BroncoSpace-Lab/CADENCE-Power/README.md

This repository contains the development of the Solar and Battery Management system Boards that will be used for the CADENCE mission.
