BroncoSpace-Lab/CADENCE-Power/CADENCE Inhibit System Test Board/.step

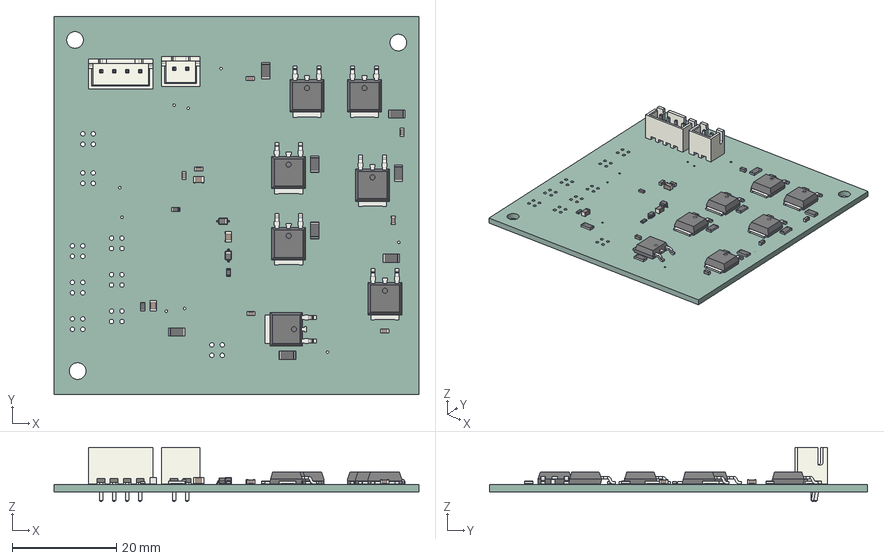
[picture p1: CAD file, 2026-10-27]
CADENCE Inhibit System Test Board/.step
70.0 x 72.5 x 10.4 mm
R_1206_3216Metric x 8
C_0603_1608Metric x 7
JST_B2B_XH_A
R_0603_1608Metric x 3
C_0805_2012Metric x 3
932d09b3-9c39-11ed-93f0-dde97e994e83_part x 7
932d09b4-9c39-11ed-93f0-dde97e994e83_part x 7
932d09b5-9c39-11ed-93f0-dde97e994e83_part x 7
D_SOD-323 x 2
JST_B4B_XH_A
CADENCE Inhibit System Test Board_PCB
