BroncoSpace-Lab/CADENCE-Power/CADENCE Solar Board/Component Footprints & Models & Symbols/LIB_STPS1045B/STPS1045B/3D/STPS1045B.stp

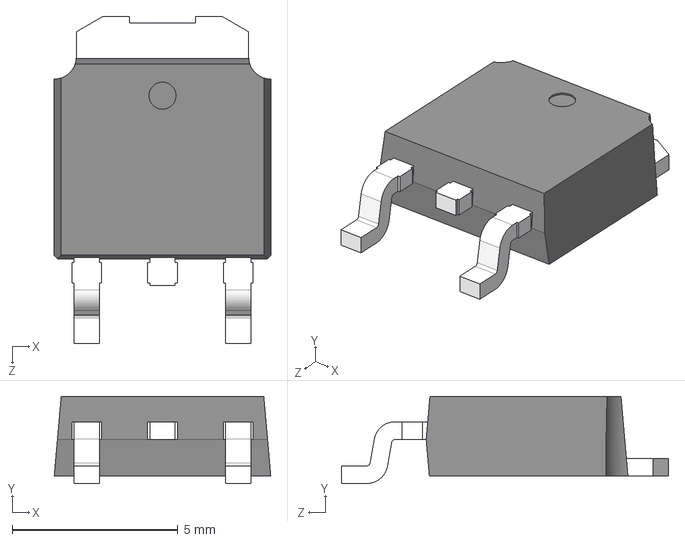
[picture p2: CAD file, 2026-10-27]
CADENCE Solar Board/Component Footprints & Models & Symbols/LIB_STPS1045B/STPS1045B/3D/STPS1045B.stp
6.54 x 2.63 x 9.88 mm
