BroncoSpace-Lab/CADENCE-Power/CADENCE BMS Board V1/.step

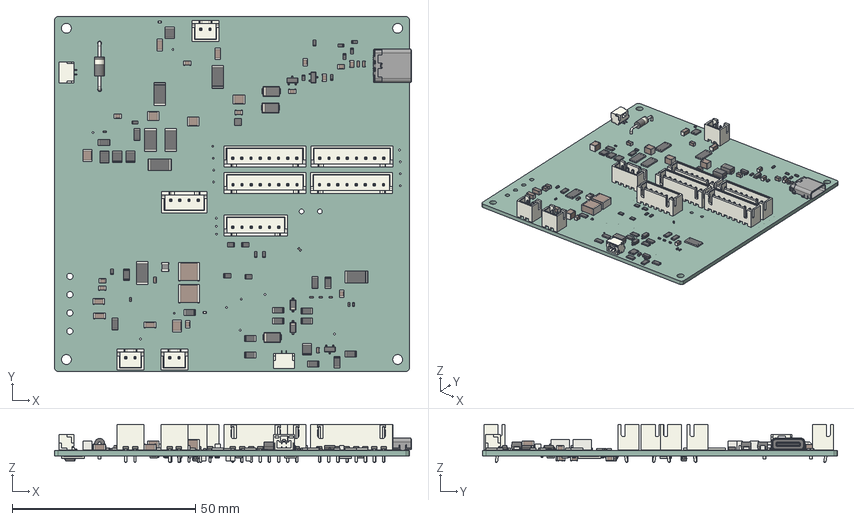
[picture p3: CAD file, 2026-07-20, an earlier design]
CADENCE BMS Board V1/.step
97.5 x 97.0 x 10.4 mm
C_1206_3216Metric x 5
L_1008_2520Metric
R_1206_3216Metric x 17
R_0603_1608Metric x 14
WSON_6_1EP_2x2mm_P065mm_EP1x16mm
SOT-23 x 2
C_0603_1608Metric x 4
R_0805_2012Metric x 8
C_0805_2012Metric x 16
D_DO-41_SOD81_P12.70mm_Horizontal
R_1210_3225Metric x 5
C_0402_1005Metric x 9
LED_0402_1005Metric x 2
JST_B2B_XH_A x 3
D_SMA x 3
JST_B8B_XH_A x 4
R_0402_1005Metric x 5
R_2512_6332Metric x 9
JST_SM02B_GHS_TB x 2
JST_B4B_XH_A
C_1210_3225Metric x 5
C_2220_5750Metric x 2
USB_C_Receptacle_Amphenol_12401610E4-2A
D_SOD-123 x 4
SOT-23-3
JST_B6B_XH_A
BMS_Board_Prototype_PCB
