BroncoSpace-Lab/CADENCE-Power/CADENCE BMS Board V1/Imported_footprints/LIB_LC-04T/LC-04T/3D/LC-04T.stp

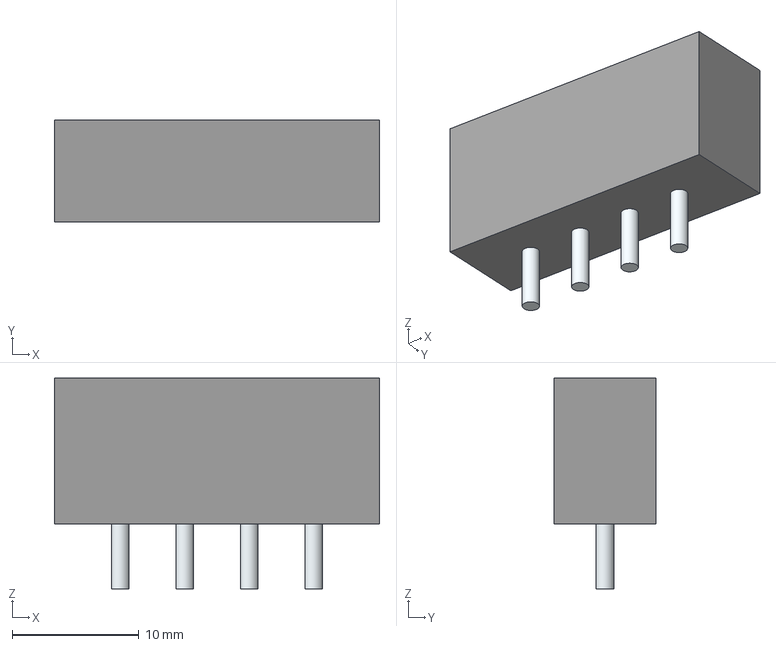
[picture p4: CAD file, 2026-10-27, an earlier design]
CADENCE BMS Board V1/Imported_footprints/LIB_LC-04T/LC-04T/3D/LC-04T.stp
25.6 x 8.00 x 16.6 mm
Leads
