BroncoSpace-Lab/CADENCE-Power/(list of files, cad)

Other CAD files:
CADENCE BMS Board V1/Imported_footprints/LIB_LC-04T/LC-04T/Allegro/lc04t.psm
CADENCE Solar Board/Component Footprints & Models & Symbols/LIB_OPT3001IDNPRQ1/OPT3001IDNPRQ1/DEHDL/opt3001idnprq1/chips/chips.prt
CADENCE Solar Board/Component Footprints & Models & Symbols/LIB_STPS1045B/STPS1045B/Allegro/t405600btr.psm
CADENCE Solar Board/Component Footprints & Models & Symbols/LIB_STPS1045B/STPS1045B/DEHDL/stps1045b/chips/chips.prt
Cadence BMS Board V2/Imported_footprints/LIB_B02P-XL-HDS___LF__SN_/B02P-XL-HDS___LF__SN_/Allegro/shdr2w120p580x500_2x1_790x1380x1460p.psm
Cadence BMS Board V2/Imported_footprints/LIB_B02P-XL-HDS___LF__SN_/B02P-XL-HDS___LF__SN_/DEHDL/b02p_xl_hds___lf__sn_/chips/chips.prt
Cadence BMS Board V2/Imported_footprints/LIB_LC-04T/LC-04T/DEHDL/lc_04t/chips/chips.prt
