BroncoSpace-Lab/CADENCE-Power/(list of files, drawings)

Other design files:
CADENCE Solar Board/Component Footprints & Models & Symbols/LIB_INA230AIRGTT/INA230AIRGTT/Altium/QFN50P300X300X100-17N-D.PcbLib
