BroncoSpace-Lab/CADENCE-Power/CADENCE Solar Board/Solar Board/Solar Board.kicad_pcb

## KiCad design CADENCE Solar Board/Solar Board/Solar Board.kicad_pcb (2026-10-27)

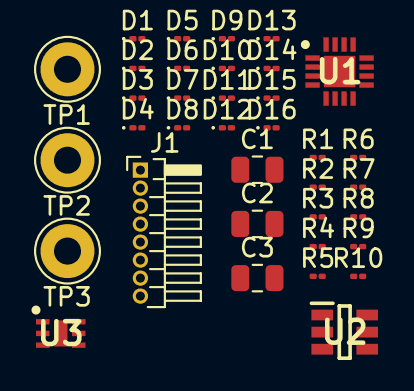
[picture p5: board Solar Board.kicad_pcb from above]

Board: 2 copper layers, 36 parts (0 on the bottom side), 32 nets, no tracks yet.

Parts:
C1, C3: 100nF; C_0805_2012Metric
C2: 10uF; C_0805_2012Metric
D1, D2, D3, D4, D5, D6, D7, D8, D9, D10, D11, D12, D13, D14, D15, D16: D; D_01005_0402Metric
J1: Conn_01x08; PinHeader_1x08_P1.00mm_Horizontal
R1, R2, R3, R5, R6, R7, R8, R10: 10k; R_01005_0402Metric
R4: 0.01; R_01005_0402Metric
R9: 1k; R_01005_0402Metric
TP1: Sensor Input; Pin_D1.3mm_L11.0mm_LooseFit
TP2: S1+; Pin_D1.3mm_L11.0mm_LooseFit
TP3: S1-; Pin_D1.3mm_L11.0mm_LooseFit
U1: INA230AIRGTT; QFN50P300X300X100-17N-D
U2: AD7414ARTZ-1REEL7; SOT95P280X145-6N
U3: OPT3001IDNPRQ1; SON65P200X200X65-7N-D

Connections:
+3.3V: C1.2, J1.1, R1.2, R4.1, R7.1, R8.2, R10.2, TP1.1 (1_1), U1.11 (BUS), U1.12 (IN-), U2.3 (VDD), U3.1 (VDD)
GND: C1.1, C2.2, C3.2, J1.4, U1.1 (A1), U1.2 (A0), U1.10 (GND), U2.2 (GND), U3.2 (ADDR), U3.3 (GND_1), U3.7 (GND_2)
HS_I2C1_LCL: J1.7, R3.2, R5.1, U3.4 (SCL)
HS_I2C1_LDA: J1.8, R2.1, R6.1, U3.6 (SDA)
unnamed: D1.2 (A), D2.2 (A)
unnamed: D1.1 (K), D4.2 (A)
unnamed: D2.1 (K), D3.2 (A)
unnamed: D3.1 (K), D6.2 (A)
unnamed: D4.1 (K), D8.2 (A)
unnamed: D5.2 (A), D6.1 (K)
unnamed: D7.2 (A), D8.1 (K)
unnamed: D5.1 (K), D10.2 (A)
unnamed: D9.2 (A), D10.1 (K)
unnamed: D11.2 (A), D12.1 (K)
unnamed: D11.1 (K), D16.2 (A)
unnamed: D7.1 (K), D12.2 (A)
unnamed: D13.2 (A), D14.1 (K)
unnamed: D13.1 (K), D15.1 (K)
unnamed: D9.1 (K), D14.2 (A)
unnamed: D15.2 (A), D16.1 (K)
unnamed: R1.1, U1.3 (ALERT)
unnamed: R4.2, U1.13 (IN+)
unnamed: R3.1, U1.5 (SCL)
unnamed: R2.2, U1.4 (SDA)
unnamed: R10.1, U1.9 (V_S+)
unnamed: C2.1, C3.1, R7.2, R9.2, U2.5 (ALERT)
unnamed: R9.1, U2.1 (AS)
unnamed: R5.2, U2.4 (SCL)
unnamed: R6.2, U2.6 (SDA)
unnamed: R8.1, U3.5 (INT)
Solar1+: J1.2, J1.3, TP2.1 (1_1)
Solar1-: J1.5, J1.6, TP3.1 (1_1)
