BroncoSpace-Lab/CADENCE-Power/CADENCE BMS Board V1/BMS_Board_Prototype.kicad_pcb

## KiCad design CADENCE BMS Board V1/BMS_Board_Prototype.kicad_pcb (2026-07-20, an earlier design)

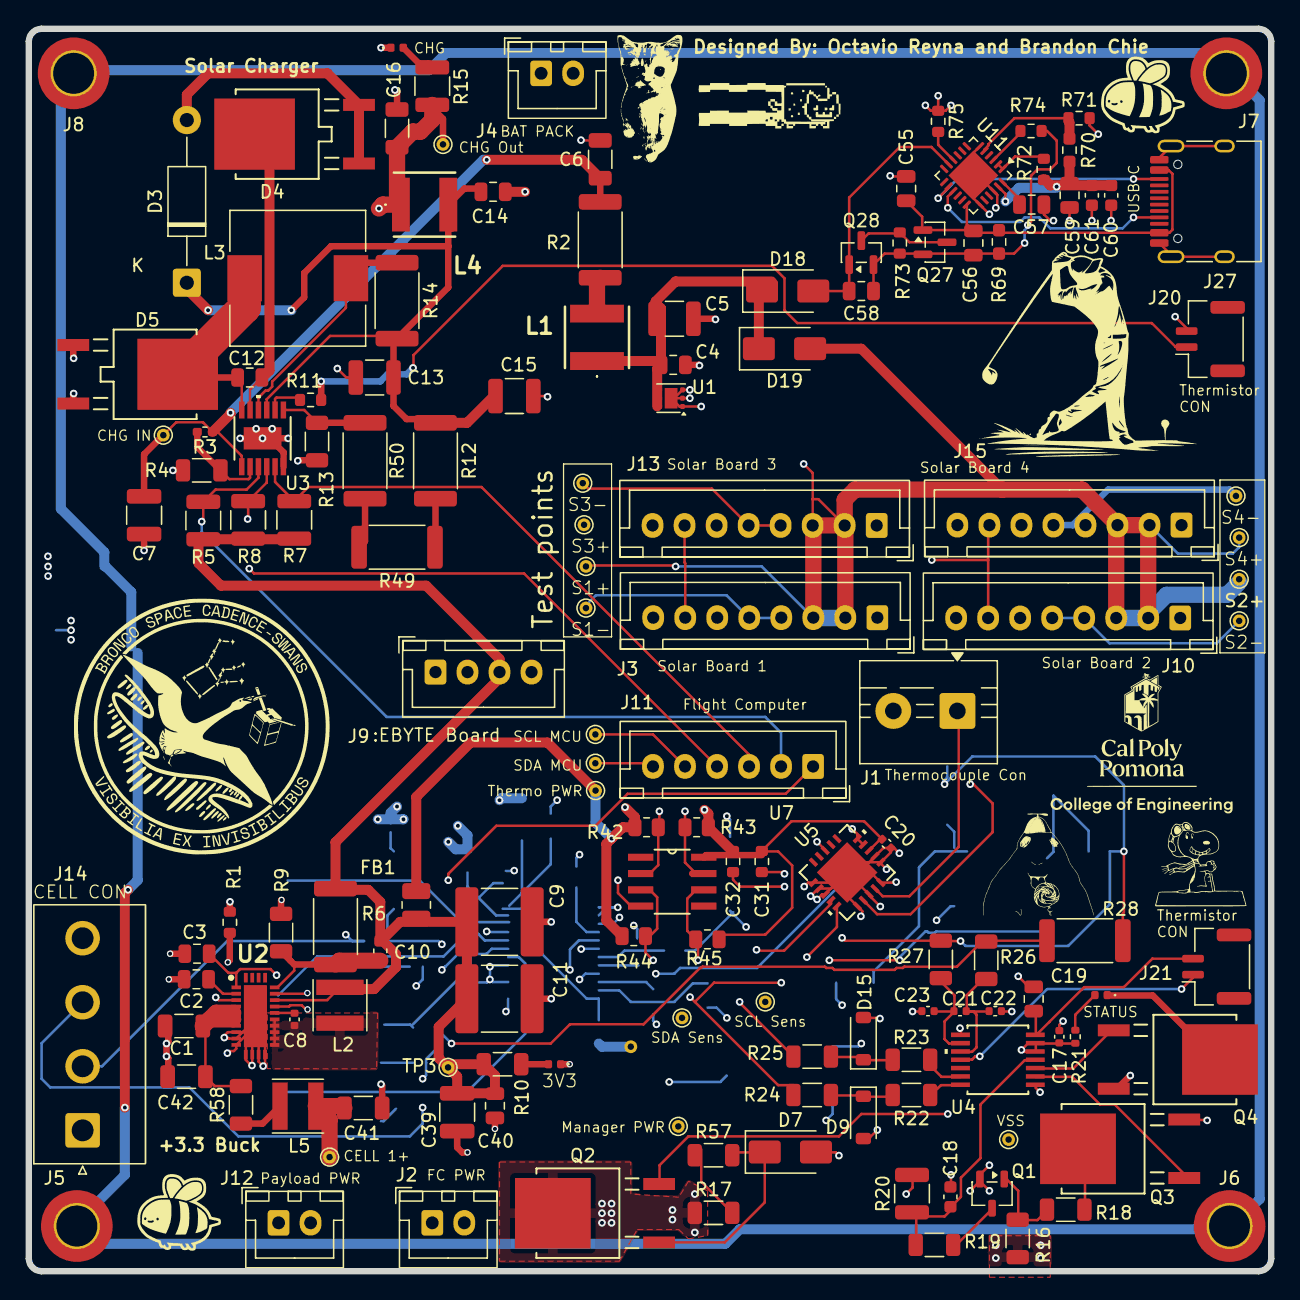
[picture p6: board BMS_Board_Prototype.kicad_pcb from above]

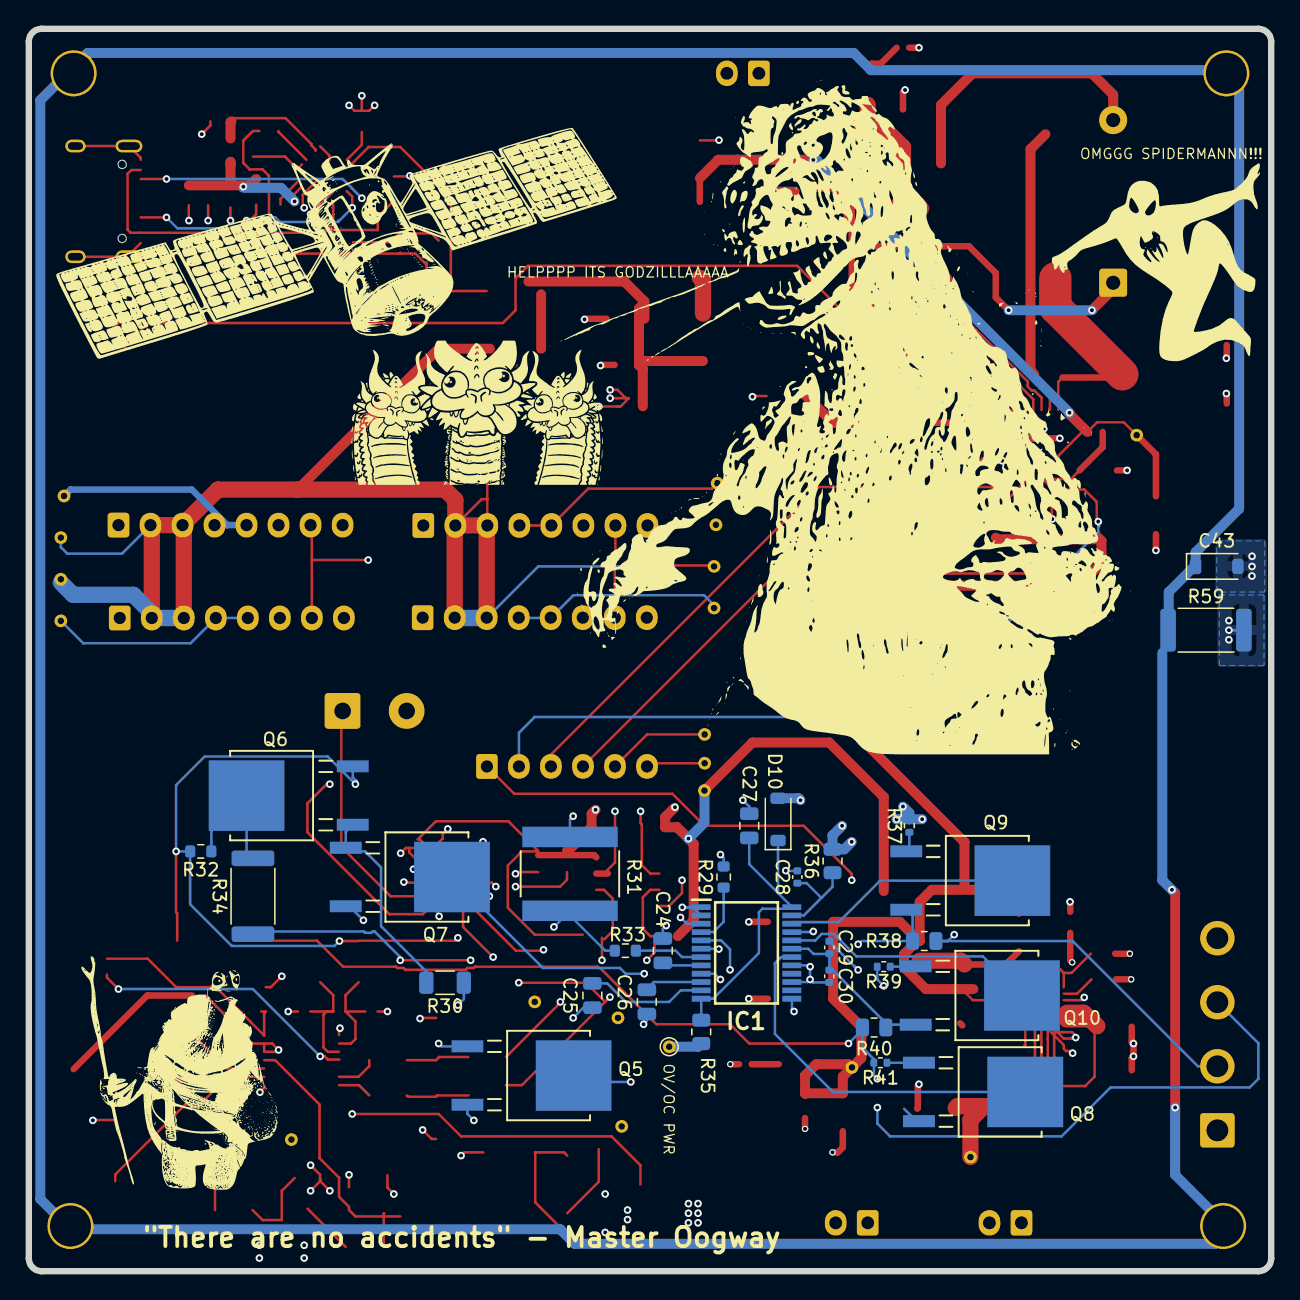
[picture p7: board BMS_Board_Prototype.kicad_pcb from below]

Board: 4 copper layers, 97.0 x 97.0 mm, 177 parts (31 on the bottom side), 95 nets.

Parts:
C1, C6, C16, C41, C42: 4.7uF; C_1206_3216Metric
C2, C4, C14, C40: 10nF; C_0805_2012Metric
C3, C12, C19, C27, C56, C57, C58, C59: 1uF; C_0805_2012Metric
C5, C7, C13, C15, C39: 10uF; C_1210_3225Metric
C8, C17, C20, C21, C22, C23, C28, C29, C30: 100nF; C_0402_1005Metric
C9, C11: 47uF; C_2220_5750Metric
C10: 4.7pF; C_0603_1608Metric
C18: 3300pF; C_0603_1608Metric
C24, C55: 3.3uF; C_0805_2012Metric
C25: 2200pF; C_0805_2012Metric
C26: .47uF; C_0805_2012Metric
C31: 1uF; R_0603_1608Metric
C32: 100nF; R_0603_1608Metric
C43: 1nF; D_SOD-123
C60, C61: 100nF; C_0603_1608Metric
D2: 3V3; LED_0402_1005Metric
D3: 1N4730APF-M (3V9); D_DO-41_SOD81_P12.70mm_Horizontal
D4, D5: STPS1045B-TR; DPAK_STM
D6: CHG; LED_0402_1005Metric
D7: 5V6; D_SMA
D8: LED; D_0402_1005Metric
D9, D15: 3.5V; D_SOD-123
D10: 15V; D_SOD-123
D18, D19: D_Schottky 40v; D_SMA
FB1: 600; L_1008_2520Metric
IC1: R5432V407BA; SOP65P760X140-24N
J1: Screw_Terminal_01x02; TerminalBlock_MaiXu_MX126-5.0-02P_1x02_P5.00mm
J2, J4, J12: Conn_01x02; JST_XH_B2B-XH-A_1x02_P2.50mm_Vertical
J3, J10, J13, J15: Conn_01x08; JST_XH_B8B-XH-A_1x08_P2.50mm_Vertical
J5, J6, J7, J8: Conn_01x01_Socket; MountingHole_3.2mm_M3_DIN965_Pad_TopOnly
J9: Conn_01x04; JST_XH_B4B-XH-A_1x04_P2.50mm_Vertical
J11: Conn_01x06; JST_XH_B6B-XH-A_1x06_P2.50mm_Vertical
J14: Conn_01x04; JST_NV_B04P-NV_1x04_P5.00mm_Vertical
J20, J21: Conn_01x02; JST_GH_SM02B-GHS-TB_1x02-1MP_P1.25mm_Horizontal
J27: USB_C_Receptacle_USB2.0_16P; USB_C_Receptacle_HRO_TYPE-C-31-M-12
L1, L4: 4.7u; FNR5040S4R7MT
L2: 1.8uH; L_Taiyo-Yuden_NR-40xx
L3: 22uH; L_10.4x10.4_H4.8
L5: 1uH; L_Taiyo-Yuden_NR-40xx
Q1: P-Channel FET; SOT-23-3
Q2, Q3, Q4: 60V Enhancement; SOT_N06-31-GE3_VIS
Q5, Q6, Q7: Q_NMOS_DSG; SOT_N06-31-GE3_VIS
Q8, Q9, Q10: N-MOS; SOT_N06-31-GE3_VIS
Q27, Q28: Q_PMOS_DGS; SOT-23
R1: 18.2k; R_0603_1608Metric
R2, R14: 0.1; R_2512_6332Metric
R3: 590k; R_0402_1005Metric_Pad0.72x0.64mm_HandSolder
R4, R16: 100k; R_1206_3216Metric
R5: 47k; R_1210_3225Metric
R6, R34, R59: 1M; R_2512_6332Metric
R7, R8: 10k; R_1210_3225Metric
R9: 412k; R_1206_3216Metric
R10: 4.7K; R_1206_3216Metric
R11: 910; R_0603_1608Metric
R12, R49: 470k; R_2512_6332Metric
R13: 340k; R_1206_3216Metric
R15: 10K; R_1210_3225Metric
R17, R57: 52.3k; R_1206_3216Metric
R18: 165k; R_1206_3216Metric
R19: 215K; R_1206_3216Metric
R20: 16.5k; R_1210_3225Metric
R21: 330; R_0402_1005Metric
R22, R23, R24, R25, R26, R27: 100; R_1206_3216Metric
R28: .037; R_2512_6332Metric
R29, R33, R75: 10K; R_0603_1608Metric
R30: 11.5K; R_1206_3216Metric
R31: .05; STA_CSSH2728_STP
R32: 2M; R_0603_1608Metric
R35, R36, R38, R40, R42, R43: 330; R_0805_2012Metric
R37, R39, R41: 100; R_0402_1005Metric
R44, R45: 4.7K; R_0805_2012Metric
R50: 1k; R_2512_6332Metric
R58: 0.1; R_1206_3216Metric
R69: 10K; R_0603_1608Metric_Pad0.98x0.95mm_HandSolder
R70: 5.1K; R_0603_1608Metric_Pad0.98x0.95mm_HandSolder
R71: 2.4K; R_0603_1608Metric
R72: 0; R_0603_1608Metric
R73, R74: 49.9K; R_0603_1608Metric
TP1: UNREG; TestPoint_THTPad_D1.0mm_Drill0.5mm
TP2: Charger-IN; TestPoint_THTPad_D1.0mm_Drill0.5mm
TP3: 3V3; TestPoint_THTPad_D1.0mm_Drill0.5mm
TP4: Charger-Out; TestPoint_THTPad_D1.0mm_Drill0.5mm
TP5: Manager-PWR; TestPoint_THTPad_D1.0mm_Drill0.5mm
TP6: VSS; TestPoint_THTPad_D1.0mm_Drill0.5mm
TP7: Thermo-PWR; TestPoint_THTPad_D1.0mm_Drill0.5mm
TP8: OV/OC PWR; TestPoint_THTPad_D1.0mm_Drill0.5mm
TP9: S1-; TestPoint_THTPad_D1.0mm_Drill0.5mm
TP10: S1+; TestPoint_THTPad_D1.0mm_Drill0.5mm
TP11: S2+; TestPoint_THTPad_D1.0mm_Drill0.5mm
TP12: S2-; TestPoint_THTPad_D1.0mm_Drill0.5mm
TP13: S3+; TestPoint_THTPad_D1.0mm_Drill0.5mm
TP14: S3-; TestPoint_THTPad_D1.0mm_Drill0.5mm
TP15: S4+; TestPoint_THTPad_D1.0mm_Drill0.5mm
TP16: S4-; TestPoint_THTPad_D1.0mm_Drill0.5mm
TP17: SDA-MCU; TestPoint_THTPad_D1.0mm_Drill0.5mm
TP18: SCL-MCU; TestPoint_THTPad_D1.0mm_Drill0.5mm
TP19: SDA-Sensor; TestPoint_THTPad_D1.0mm_Drill0.5mm
TP20: SCL-Sensor; TestPoint_THTPad_D1.0mm_Drill0.5mm
U1: TVS2200DRV; WSON-6-1EP_2x2mm_P0.65mm_EP1x1.6mm
U2: LT8612; QFN50P300X600X80-29N-D
U3: LT3652IMSE#PBF; MSOP-12_MSE_LIT
U4: BQ34Z100-R2; PW14_TEX
U5: MCP9600-E_MX; MQFN20_NU_MCH
U7: P82B715DR; D8
U11: CYPD3177-24LQ; QFN-24-1EP_4x4mm_P0.5mm_EP2.75x2.75mm

Connections:
3V3 Power Good: J11.1, U2.23 (PG)
+3.3V: C9.2, C10.2, C11.2, C39.1, C40.1, FB1.2, J3.1, J9.3, J10.1, J13.1, J15.1, L2.2, R5.1, R6.2, R7.1, R8.1, R10.1, R75.1, TP3.1 (1_1), U2.22 (BIAS)
+3.3V Q: C20.2, C31.1, C32.1, FB1.1, R42.1, R43.1, R44.1, R45.1, TP7.1 (1_1), U5.8 (VDD), U7.8 (Vcc)
/Power/3v3 Feedback: C10.1, R6.1, R9.1, U2.24 (FB)
/Power/3v3 SW: C8.1, L2.1, U2.15 (SW), U2.16 (SW), U2.17 (SW), U2.18 (SW), U2.19 (SW)
/Sensors/REGIN: C17.1, Q2.2 (S), R21.1, U4.5 (CE), U4.6 (REGIN)
/Sensors/Serial Clock: R23.1, U4.13 (P4/SCL)
/Sensors/Serial Data: R22.1, U4.14 (P3/SDA)
/Sensors/Voltage Divider: C18.2, R19.2, R20.1, U4.4 (BAT)
/Sensors/Voltage Divider Enable: Q3.3 (D), R18.2
CB1: IC1.22 (CB1), Q9.3 (G)
CB2: IC1.20 (CB2), Q10.3 (G)
CB3: IC1.18 (CB3), Q8.3 (G)
CC1: J27.A5 (CC1), U11.15 (CC1)
CC2: J27.B5 (CC2), U11.14 (CC2)
CHG': J11.4, R8.2, U3.4 (~CHRG)
Cell 1+: C16.1, C41.1, J2.1, J4.1, J9.1, J12.1, J14.1, L4.1, L5.1, Q1.2 (S), Q2.3 (D), R15.1, R16.1, R17.1, R35.1, R36.2, R37.2, TP1.1 (1_1), TP4.1 (1_1), TP5.1 (1_1), TP8.1 (1_1)
Cell 2+: J14.2, R38.2, R39.2
Cell 3+: J14.3, R26.2, R28.1, R40.2, R41.2
Cell 3-: C1.2, C2.1, C3.1, C4.2, C5.2, C6.2, C7.2, C9.1, C11.1, C13.2, C14.2, C15.2, C16.2, C17.2, C18.1, C19.1, C20.1, C22.1, C23.1, C24.1, C25.2, C26.1, C27.2, C30.2, C31.2, C32.2, C39.2, C40.2, C41.2, C42.2, C43.2, C55.2, C57.1, C59.2, C60.2, C61.2, D2.1 (K), D5.1 (A), D6.1 (K), D7.2 (A), D9.2 (A), D10.2 (A), D15.2 (A), IC1.1 (CTLC), IC1.2 (CTLD), IC1.9 (VSS), IC1.13 (SEL2), IC1.15 (VC5), IC1.17 (VC4), J2.2, J3.4, J3.5, J3.6, J4.2, J9.2, J9.4, J10.4, J10.5, J10.6, J12.2, J13.4, J13.5, J13.6, J14.4, J15.4, J15.5, J15.6, J20.2, J27.A1 (GND), J27.A12 (GND), J27.B1 (GND), J27.B12 (GND), J27.SH (SHIELD), Q3.2 (S), Q4.2 (S), Q5.2 (S), Q6.2 (S), Q8.2 (S), R1.2, R4.2, R9.2, R13.2, R20.2, R27.2, R28.2, R29.2, R31.1, R32.2, R59.2, R71.2, TP6.1 (1_1), TP9.1 (1_1), TP12.1 (1_1), TP14.1 (1_1), TP16.1 (1_1), U1.1 (GND), U1.2 (GND), U1.3 (GND), U1.7 (GND), U2.8 (PGND), U2.9 (PGND), U2.10 (PGND), U2.11 (GND), U2.12 (GND), U2.13 (GND), U2.14 (GND), U2.29 (GND), U3.6 (TIMER), U3.13 (GND), U4.1 (P2), U4.8 (VSS), U5.1 (GND), U5.3 (GND), U5.5 (GND), U5.6 (GND), U5.7 (GND), U5.9 (GND), U5.10 (GND), U5.13 (GND), U5.16 (ADDR), U5.17 (GND), U5.18 (GND), U5.21 (EXP), U7.4 (GND), U11.6 (ISNK_FINE), U11.19 (GND), U11.22 (GND), U11.25 (GND)
DRAIN: IC1.5 (DRAIN), Q5.3 (G)
FAULT': J11.3, R7.2, U3.5 (~FAULT)
HS_I2C1_LCL: J3.7, J10.7, J11.5, J13.7, J15.7, R43.2, TP18.1 (1_1), U7.7 (Ly)
HS_I2C1_LDA: J3.8, J10.8, J11.6, J13.8, J15.8, R42.2, TP17.1 (1_1), U7.2 (Lx)
HS_I2C1_SCL: R25.2, R45.2, TP20.1 (1_1), U5.19 (SCL), U7.6 (Sy)
HS_I2C1_SDA: R24.2, R44.2, TP19.1 (1_1), U5.20 (SDA), U7.3 (Sx)
NTC: J20.1, R11.2
unnamed: C43.1, J5.1 (1_1), J6.1 (1_1), J7.1 (1_1), J8.1 (1_1), R59.1
unnamed: D2.2 (A), R10.2
unnamed: D3.2 (A), D4.1 (A)
unnamed: C13.1, C14.1, C15.1, D3.1 (K), L4.2, R12.1, R14.2, U3.9 (BAT)
unnamed: C12.2, D4.2 (K), U3.11 (BOOST)
unnamed: C12.1, D5.2 (K), L3.1, U3.12 (SW)
unnamed: D6.2 (A), R15.2
unnamed: D7.1 (K), Q2.1 (G), R57.2
unnamed: D8.2 (A), R21.2
unnamed: D8.1 (K), Q4.3 (D)
unnamed: D9.1 (K), R22.2, R24.1
unnamed: D15.1 (K), R23.2, R25.1
unnamed: C4.1, C5.1, D18.1 (K), D19.1 (K), L1.1, U1.4 (IN), U1.5 (IN), U1.6 (IN)
unnamed: IC1.3 (COUT), R34.1
unnamed: C26.2, IC1.10 (CT1)
unnamed: C25.1, IC1.11 (CT2)
unnamed: C24.2, IC1.8 (CTLT)
unnamed: IC1.6 (DOUT), Q7.3 (G)
unnamed: IC1.7 (SENS), R33.2
unnamed: C28.1, IC1.23 (VC1), R36.1
unnamed: C28.2, C29.1, IC1.21 (VC2), Q9.2 (S), R38.1
unnamed: C29.2, C30.1, IC1.19 (VC3), Q10.2 (S), R40.1
unnamed: J1.1, U5.4 (VIN-)
unnamed: J1.2, U5.2 (VIN+)
unnamed: J21.1, U4.11 (P6/TS)
unnamed: L1.2, R2.1
unnamed: L5.2, R58.1
unnamed: Q1.3 (D), R19.1
unnamed: Q1.1 (G), R16.2, R18.1
unnamed: Q3.1 (G), U4.2 (VEN)
unnamed: Q4.1 (G), U4.3 (P1)
unnamed: Q5.1 (D), R30.1
unnamed: Q6.1 (D), Q7.1 (D), R30.2
unnamed: Q6.3 (G), R32.1, R34.2
unnamed: Q7.2 (S), R31.2, R33.1
unnamed: Q8.1 (D), R41.1
unnamed: Q9.1 (D), R37.1
unnamed: Q10.1 (D), R39.1
unnamed: C56.2, C58.2, Q27.2 (G), Q28.2 (G), R69.2, R73.2, R74.1
unnamed: Q27.3 (S), Q28.3 (S), R73.1
unnamed: R12.2, R49.1
unnamed: R17.2, R57.1
unnamed: R49.2, R50.1
unnamed: C8.2, U2.20 (BST)
unnamed: C1.1, C42.1, R58.2, U2.4 (EN/UV), U2.5 (VIN), U2.6 (VIN), U2.7 (VIN)
unnamed: C3.2, U2.1 (SYNC), U2.21 (INTVCC)
unnamed: R1.1, U2.3 (RT)
unnamed: C2.2, U2.2 (TR/SS)
unnamed: R11.1, U3.8 (NTC)
unnamed: L3.2, R14.1, U3.10 (SENSE)
unnamed: R13.1, R50.2, U3.7 (VFB)
unnamed: C6.1, C7.1, R2.2, R3.1, TP2.1 (1_1), U3.1 (VIN)
unnamed: R3.2, R4.1, U3.2 (VIN_REG)
unnamed: C21.1, C22.2, R26.1, U4.10 (SRN)
unnamed: C21.2, C23.2, R27.1, U4.9 (SRP)
unnamed: R75.2, U11.10 (FLIP)
unnamed: R70.2, R71.1, U11.5 (ISNK_COARSE)
unnamed: R72.2, U11.1 (VBUS_MIN), U11.2 (VBUS_MAX)
unnamed: C57.2, U11.24 (VCCD)
REG25: C19.2, J21.2, U4.7 (REG25)
SHDN': J11.2, R5.2, U3.3 (~SHDN)
Solar Power: D19.2 (A), J3.2, J3.3, J10.2, J10.3, J13.2, J13.3, J15.2, J15.3, TP10.1 (1_1), TP11.1 (1_1), TP13.1 (1_1), TP15.1 (1_1)
VBUS: C55.1, C56.1, J27.A4 (VBUS), J27.A9 (VBUS), J27.B4 (VBUS), J27.B9 (VBUS), Q27.1 (D), R69.1, U11.18 (VBUS_IN)
VBUS_EN: R74.2, U11.3 (VBUS_FET_EN)
VDC_OUT: C58.1, D18.2 (A), Q28.1 (D), U11.11 (VDC_OUT)
VDD: C27.1, D10.1 (K), IC1.12 (SEL1), IC1.24 (VDD), R35.2
VDDD: C59.1, C60.1, C61.1, R70.1, R72.1, U11.23 (VDDD)
VMP: IC1.4 (VMP), R29.1
