BroncoSpace-Lab/CADENCE-Power/(commit log)

2026-07-15 Moved power files
    Moved from CADENCE Octavio-BMS branch. Original files still remain there
    [BMS_Board_Prototype.kicad_pcb, BMS_Board_Prototype.kicad_sch, External_Board_Connections.kicad_sch, I2C_Components.kicad_sch, Inhibit_System.kicad_sch, Power.kicad_sch, Sensor.kicad_sch]
2026-07-15 File Organization
    [BMS_Board_Prototype.kicad_pcb, BMS_Board_Prototype.kicad_sch, External_Board_Connections.kicad_sch, I2C_Components.kicad_sch, Inhibit_System.kicad_sch, Power.kicad_sch, Sensor.kicad_sch]
2026-07-15 Adding in Solar Board folder
    [BMS_Board_Prototype.kicad_pcb, BMS_Board_Prototype.kicad_sch, External_Board_Connections.kicad_sch, I2C_Components.kicad_sch, Inhibit_System.kicad_sch, Power.kicad_sch, Sensor.kicad_sch]
2026-07-15 Added in Solar Board Files
    [Regulator EMI Filter.kicad_sch, Solar Board.kicad_sch, Solar Charger EMI Filter Circuit.kicad_sch]
2026-07-15 Name update
    [BMS_Board_Prototype.kicad_pcb, BMS_Board_Prototype.kicad_sch, External_Board_Connections.kicad_sch, I2C_Components.kicad_sch, Inhibit_System.kicad_sch, Power.kicad_sch, Sensor.kicad_sch]
2026-07-15 Fix folder name
    [BMS_Board_Prototype.kicad_pcb, BMS_Board_Prototype.kicad_sch, External_Board_Connections.kicad_sch, I2C_Components.kicad_sch, Inhibit_System.kicad_sch, Power.kicad_sch, Sensor.kicad_sch]
2026-07-16 Updates to the Inhibit system and Connectors
    [BMS_Board_Prototype.kicad_pcb, Inhibit_System.kicad_sch, Sensor.kicad_sch]
2026-07-16 Changed the name of the file
    V1
    [BMS_Board_Prototype_V1.kicad_sch]
2026-07-16 Changed name to V2
    [BMS_Board_Prototype_V2.kicad_sch]
2026-07-16 Removed filters
    Solar Charger & Power Regulator
    [BMS_Board_Prototype_V2.kicad_sch, External_Board_Connections.kicad_sch, I2C_Components.kicad_sch, Inhibit_System.kicad_sch, Power.kicad_sch, Sensor.kicad_sch]
2026-07-16 Fixed some inhibits
    [Inhibit_System.kicad_sch]
2026-07-18 Minor Fixes
    added test point and output back to solar charger and cleaned up inhibit system a little bit
    [Inhibit_System.kicad_sch, Power.kicad_sch]
2026-07-20 Finalizing updates for V1 of BMS
    [.step, BMS_Board_Prototype.kicad_pcb, BMS_Board_Prototype.kicad_sch, External_Board_Connections.kicad_sch, I2C_Components.kicad_sch, Inhibit_System.kicad_sch, Power.kicad_sch, Sensor.kicad_sch]
2026-07-20 Cleaning up for BMS V1
    [BMS_Board_Prototype.kicad_pcb]
2026-07-20 Fixing Stuff
    [BMS_Board_Prototype.kicad_sch]
2026-07-21 Updates for banana plug power testing
    [.step, BMS_Board_Prototype.kicad_pcb, BMS_Board_Prototype.kicad_sch, External_Board_Connections.kicad_sch, I2C_Components.kicad_sch, Inhibit_System.kicad_sch, Power.kicad_sch, Sensor.kicad_sch]
2026-07-21 Removed 3v3Q
    Removed 3v3Q, Capacitors (EMI FILTER OUT), Changed all +3.3V Q -> 3.3V
    [I2C_Components.kicad_sch, Power.kicad_sch, Sensor.kicad_sch]
2026-07-23 Updates for USB-C charging and set up for testing
    Revamped USB-C layout to make it cleaner and more compressed and also included schematic parts for adding in Banana plugs for testing the PCB
    [BMS_Board_Prototype.kicad_pcb, BMS_Board_Prototype.kicad_sch, External_Board_Connections.kicad_sch, I2C_Components.kicad_sch, Power.kicad_sch]
2026-07-23 Added new inhibit Folder
    Inhibit Test PCB
    [CADENCE Inhibit System Test Board.kicad_pcb, CADENCE Inhibit System Test Board.kicad_sch]
2026-07-23 Updated reference designators for Inhibit System
    Automatically updated ref designators
    [CADENCE Inhibit System Test Board.kicad_sch]
2026-07-27 New connectors and adding in a test setup
    [BMS_Board_Prototype.kicad_pcb, External_Board_Connections.kicad_sch, Power.kicad_sch, Sensor.kicad_sch]
2026-07-28 Updates to incorporate inhibit board
    [BMS_Board_Prototype.kicad_pcb, External_Board_Connections.kicad_sch, Power.kicad_sch]
2026-07-28 Updates to finalize V1
    [BMS_Board_Prototype.kicad_pcb, External_Board_Connections.kicad_sch]
2026-07-28 Updates to the Inhibit system footprints
2026-07-28 Fixing up inhibit system footprints
2026-07-28 Updates for connector footprint
    [BMS_Board_Prototype.kicad_pcb, External_Board_Connections.kicad_sch]
2026-07-29 Final Changes for Manufacturing
    [BMS_Board_Prototype.kicad_pcb]
2026-07-29 Fabrication Files
    Adding in the files need for the fabrication of the PCB. Used the interactive BOM and the JLC addition tool to add in components
    [BMS_Board_Prototype-CuBottom.gbr, BMS_Board_Prototype-CuIn1.gbr, BMS_Board_Prototype-CuIn2.gbr, BMS_Board_Prototype-CuTop.gbr, BMS_Board_Prototype-EdgeCuts.gbr, BMS_Board_Prototype-MaskBottom.gbr, BMS_Board_Prototype-MaskTop.gbr, BMS_Board_Prototype-NPTH.drl]
2026-07-30 Fabrication files fixing issues
    [BMS_Board_Prototype-CuBottom.gbr, BMS_Board_Prototype-CuIn1.gbr, BMS_Board_Prototype-CuIn2.gbr, BMS_Board_Prototype-CuTop.gbr, BMS_Board_Prototype-EdgeCuts.gbr, BMS_Board_Prototype-MaskBottom.gbr, BMS_Board_Prototype-MaskTop.gbr, BMS_Board_Prototype-NPTH.drl]
2026-07-30 PCB additions
    [BMS_Board_Prototype.kicad_pcb]
2026-07-30 uPdated parts
    [BMS_Board_Prototype.kicad_pcb]
2026-07-30 Updates for fabrication
    [BMS_Board_Prototype-CuBottom.gbr, BMS_Board_Prototype-CuIn1.gbr, BMS_Board_Prototype-CuIn2.gbr, BMS_Board_Prototype-CuTop.gbr, BMS_Board_Prototype-EdgeCuts.gbr, BMS_Board_Prototype-MaskBottom.gbr, BMS_Board_Prototype-MaskTop.gbr, BMS_Board_Prototype-NPTH.drl]
2026-07-30 Delted unnecessary files, added project files, and custom footprints
    [EDI2CAP.CFG, OPT3001IDNPRQ1.SchLib, OPT3001IDNPRQ1.stp, Regulator EMI Filter.kicad_pcb, Regulator EMI Filter.kicad_sch, SON65P200X200X65-7N-D.PcbLib, Solar Board.kicad_pcb, Solar Board.kicad_sch]
2026-07-31 Updates for BMS for final manufacturing
    [BMS_Board_Prototype-CuBottom.gbr, BMS_Board_Prototype-CuIn1.gbr, BMS_Board_Prototype-CuIn2.gbr, BMS_Board_Prototype-CuTop.gbr, BMS_Board_Prototype-EdgeCuts.gbr, BMS_Board_Prototype-MaskBottom.gbr, BMS_Board_Prototype-MaskTop.gbr, BMS_Board_Prototype-NPTH.drl]
2026-07-31 Solar board updates - connectros added, schematic simplified with flags, more descriptions, added resistor
    [Solar Board.kicad_sch]
2026-08-01 Updates for JLC
    [BMS_Board_Prototype-CuBottom.gbr, BMS_Board_Prototype-CuIn1.gbr, BMS_Board_Prototype-CuIn2.gbr, BMS_Board_Prototype-CuTop.gbr, BMS_Board_Prototype-EdgeCuts.gbr, BMS_Board_Prototype-MaskBottom.gbr, BMS_Board_Prototype-MaskTop.gbr, BMS_Board_Prototype-NPTH.drl]
2026-08-04 Updates to PCB fab Files
    [BMS_Board_Prototype-CuBottom.gbr, BMS_Board_Prototype-CuIn1.gbr, BMS_Board_Prototype-CuIn2.gbr, BMS_Board_Prototype-CuTop.gbr, BMS_Board_Prototype-EdgeCuts.gbr, BMS_Board_Prototype-MaskBottom.gbr, BMS_Board_Prototype-MaskTop.gbr, BMS_Board_Prototype-NPTH.drl]
2026-08-06 Updating footprint glitch
    [CADENCE Inhibit System Test Board.kicad_sch]
2026-08-06 Footprint Updates Pt2
2026-08-07 Updates to buried Vias
    [BMS_Board_Prototype.kicad_pcb]
2026-08-08 Updates to buried Vias and Minor Fixes
    [BMS_Board_Prototype-CuBottom.gbr, BMS_Board_Prototype-CuIn1.gbr, BMS_Board_Prototype-CuIn2.gbr, BMS_Board_Prototype-CuTop.gbr, BMS_Board_Prototype-EdgeCuts.gbr, BMS_Board_Prototype-MaskBottom.gbr, BMS_Board_Prototype-MaskTop.gbr, BMS_Board_Prototype-NPTH.drl]
2026-08-09 Updates to CON footprints and out of stock components for JLC
    [B02P-XL-HDS___LF__SN_.SchLib, B02P-XL-HDS___LF__SN_.stp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]
2026-08-12 Cleaning up the Schematic
    [Inhibit_System.kicad_sch]
2026-08-12 Updates for new fabrication files
    [BMS_Board_Prototype-CuBottom.gbr, BMS_Board_Prototype-CuIn1.gbr, BMS_Board_Prototype-CuIn2.gbr, BMS_Board_Prototype-CuTop.gbr, BMS_Board_Prototype-EdgeCuts.gbr, BMS_Board_Prototype-MaskBottom.gbr, BMS_Board_Prototype-MaskTop.gbr, BMS_Board_Prototype-NPTH.drl]
2026-08-12 bms connections
    connections for bms were added
2026-08-12 pcb layout
    [CADENCE Inhibit System Test Board.kicad_pcb]
2026-08-13 bms connectors
    [CADENCE Inhibit System Test Board.kicad_sch]
2026-08-13 test points added
    [CADENCE Inhibit System Test Board.kicad_sch]
2026-08-13 added footprints to testpoints
    [CADENCE Inhibit System Test Board.kicad_sch]
2026-08-13 pcb layout
    confident in completion of IC3, IC4, IC1, foot switches, and low power side
    [CADENCE Inhibit System Test Board.kicad_pcb, CADENCE Inhibit System Test Board.kicad_sch]
2026-08-14 added solar cells with diodes
    8s2p solar cell configuration with bypass diodes
    [Solar Board.kicad_sch]
2026-08-16 solar board with diodes reupload
2026-08-16 attached documentation files
2026-08-17 PCB Updates: added traces
    [CADENCE Inhibit System Test Board.kicad_pcb, CADENCE Inhibit System Test Board.kicad_sch]
2026-08-17 removed obsolete kicad models and added pcb footprints
    [AD7414ARTZ-1REEL7.SchLib, AD7414ARTZ-1REEL7.stp, EDI2CAP.CFG, INA230AIRGTT.SchLib, INA230AIRGTT.stp, OPT3001IDNPRQ1.SchLib, OPT3001IDNPRQ1.stp, QFN50P300X300X100-17N-D.PcbLib]
2026-08-18 added basic PCB layout and attached footprints to parts (excluding solar cells. a lot might need updating later)
    [AD7414ARTZ-1REEL7.SchLib, AD7414ARTZ-1REEL7.stp, EDI2CAP.CFG, INA230AIRGTT.SchLib, INA230AIRGTT.stp, OPT3001IDNPRQ1.SchLib, OPT3001IDNPRQ1.stp, QFN50P300X300X100-17N-D.PcbLib]
2026-08-22 corrected board based on octavio's review
    [Solar Board.kicad_sch]
2026-08-24 corrected board based on octavio's review
    added led with resistor to ALERT pins, removed extra resistors, biased high configuration for the voltage/current sensor
    [Solar Board.kicad_sch]
2026-08-26 more fixes (diodes are placeholders)
    removed extra resistors, corrected LEDs
    [Solar Board.kicad_sch]
2026-08-26 More documentation on Fault signal Voltages
    [Power.kicad_sch]
2026-08-27 Updated for an error found with Power good alert
    [External_Board_Connections.kicad_sch, Power.kicad_sch]
2026-08-28 tracing more
    [CADENCE Inhibit System Test Board.kicad_pcb, CADENCE Inhibit System Test Board.kicad_sch]
2026-08-28 Continued adding traces for gnd
    [CADENCE Inhibit System Test Board.kicad_pcb, CADENCE Inhibit System Test Board.kicad_sch]
2026-09-02 fixed LEDs and reduced amount of bypass diodes by half
    [Solar Board.kicad_sch]
2026-09-02 finished connections and added vias
    [CADENCE Inhibit System Test Board.kicad_pcb]
2026-09-02 fixed diodes
    [Solar Board.kicad_pcb, Solar Board.kicad_sch]
2026-09-03 minor pcb and schematic updates
    [Solar Board.kicad_pcb, Solar Board.kicad_sch]
2026-09-05 Updates to Schematic
    Found an error with power delivery USB-C and with the solar charger
    [External_Board_Connections.kicad_sch, Power.kicad_sch]
2026-09-06 Troubleshooting Notes on things to change for next revision
    Updates to the Solar charger to ensure it powers on and updates to USB-C schematic fixing an error with the pinouts of the p channel FETS
    [External_Board_Connections.kicad_sch, Power.kicad_sch]
2026-09-07 pcb silkscreens
    i did a bit :p
    [CADENCE Inhibit System Test Board.kicad_pcb]
2026-09-08 silkscreen update
    [CADENCE Inhibit System Test Board.kicad_pcb]
2026-09-08 updated BOM
    [CADENCE Inhibit System Test Board.kicad_pcb]
2026-09-08 PCB Optimized (made smaller)
    [Solar Board.kicad_pcb, Solar Board.kicad_sch]
2026-09-09 fixed silkscreen
    [CADENCE Inhibit System Test Board.kicad_pcb]
2026-09-09 made pcb smaller
    [CADENCE Inhibit System Test Board.kicad_pcb]
2026-09-09 mounting holes added
    [CADENCE Inhibit System Test Board.kicad_pcb, CADENCE Inhibit System Test Board.kicad_sch]
2026-09-09 added custom footprint for solar cell with 3D file
    [CAVU-3U-6Cell_v1.1.step]
2026-09-09 PCB updates
    added custom solar cell footprints and created base layer for the thin PCB board
    [Solar Board.kicad_pcb, Solar Board.kicad_sch]
2026-09-10 moved parts and updated mounting holes
    [.step, CADENCE Inhibit System Test Board.kicad_pcb, CADENCE Inhibit System Test Board.kicad_sch]
2026-09-10 edited layout and rerouted traces
    [CADENCE Inhibit System Test Board.kicad_pcb]
2026-09-11 edited diode footprints
    [CADENCE Inhibit System Test Board.kicad_pcb]
2026-09-14 Adding in a connector for burn wire
    Comms requested a burn wire connector that can supply the nominal 10.8V. This change will mark the start of the second version of the BMS board
    [External_Board_Connections.kicad_sch]
2026-09-16 Added names and vias
    [CADENCE Inhibit System Test Board.kicad_pcb]
2026-09-16 grounded mounting holes
    [CADENCE Inhibit System Test Board.kicad_pcb]
2026-09-16 updated schematic
    [CADENCE Inhibit System Test Board.kicad_sch]
2026-09-16 PCB updates
    added traces, moved location
    [Solar Board.kicad_pcb]
2026-09-16 added separate project folders
    8sp1 and 8sp2 are identical except for the pcb layout. solar cells are added to the 8s2p version. traces added to the pcb, had to be moved because of a previous height issue.
    [Solar Board.kicad_pcb, Solar Board.kicad_sch]
2026-09-22 edited mosfet traces
    [CADENCE Inhibit System Test Board.kicad_pcb]
2026-09-24 edited silkscreen
    [CADENCE Inhibit System Test Board.kicad_pcb]
2026-09-25 rearranged testpoints
    [CADENCE Inhibit System Test Board.kicad_pcb]
2026-09-30 compression and decor
    [CADENCE Inhibit System Test Board.kicad_pcb]
2026-10-03 Added screws
    had to reline everything due to screw holes
    [Solar Board.kicad_pcb]
2026-10-03 minor capacitor movement
    [CADENCE Inhibit System Test Board.kicad_pcb]
2026-10-07 label change and pos and bom stuff
    [CADENCE Inhibit System Test Board.kicad_pcb, CADENCE Inhibit System Test Board.kicad_sch]
2026-10-07 value name change
    [CADENCE Inhibit System Test Board.kicad_sch]
2026-10-07 changed placement of gse via
    [BOM-CADENCE Inhibit System Test Board.csv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]
2026-10-07 Updates
    removed light sensor, changed pcb design, added screw holes for 8s1p and 8s2p configurations, optimized via paths in pcb
    [Solar Board.kicad_pcb, Solar Board.kicad_sch]
2026-10-09 Updates to component testing
    [Power.kicad_sch, Sensor.kicad_sch]
2026-10-16 fixed diode footprints and added gbr and drl files
2026-10-27 File clean up for BMS V1 Folder
2026-10-27 Adding in BMS V2 file for editing
